HashikaChathubhashaka/Hot-plate-cotroller-using-PID/README.md

# Hot-plate-cotroller-using-PID

<h3>This is  a analog electronic project about making a hot plate temperature controller using PID algorithm.  </h3>

<h4> There are 4 main circuit units use to this. </h4>

<ol>
 <li>PID unit  </li>
  
 <li>Sensor Interface Unit </li>
  
 <li>Firing angle control unit  </li>
  
 <li>Power Supply Unit  </li>
  
 </ol>

<h4>Softwares And Platforms</h4>
<ul>

<li>Simulate circuit --> <i>Multisim</i> </li>
<li>PCBs --> <i>Altium  </i> </li>
<li>encloser --> <i> SolidWorks </i>  </li>
<li>Digital Display --> <i> Arduino  </i> </li>


</ul>
