HashikaChathubhashaka/Hot-plate-cotroller-using-PID/Multisim Simulations/firing angle.jpg

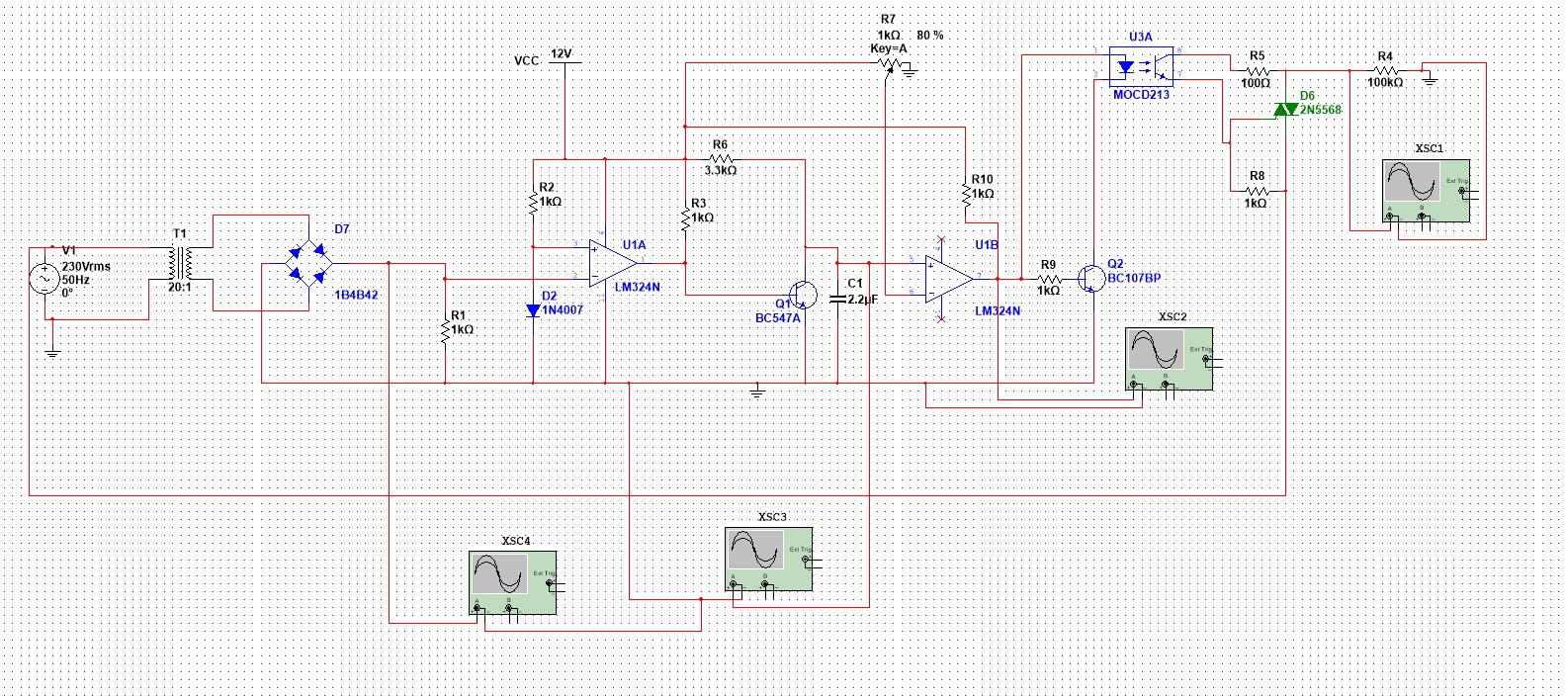
Multisim Simulations/firing angle.jpg
