HashikaChathubhashaka/Hot-plate-cotroller-using-PID/Multisim Simulations/PID.jpg

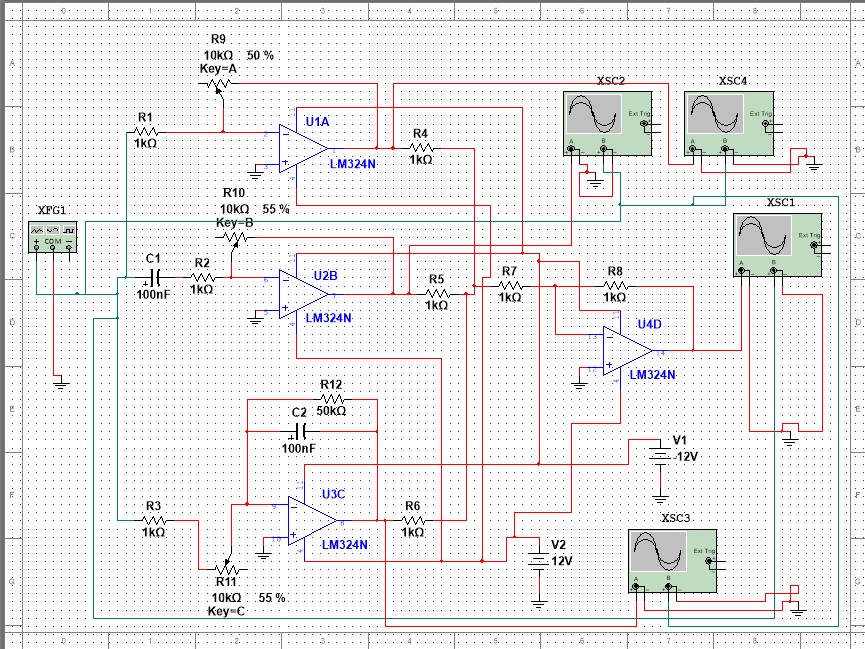
Multisim Simulations/PID.jpg
