HashikaChathubhashaka/Hot-plate-cotroller-using-PID/Multisim Simulations/power supply.jpg

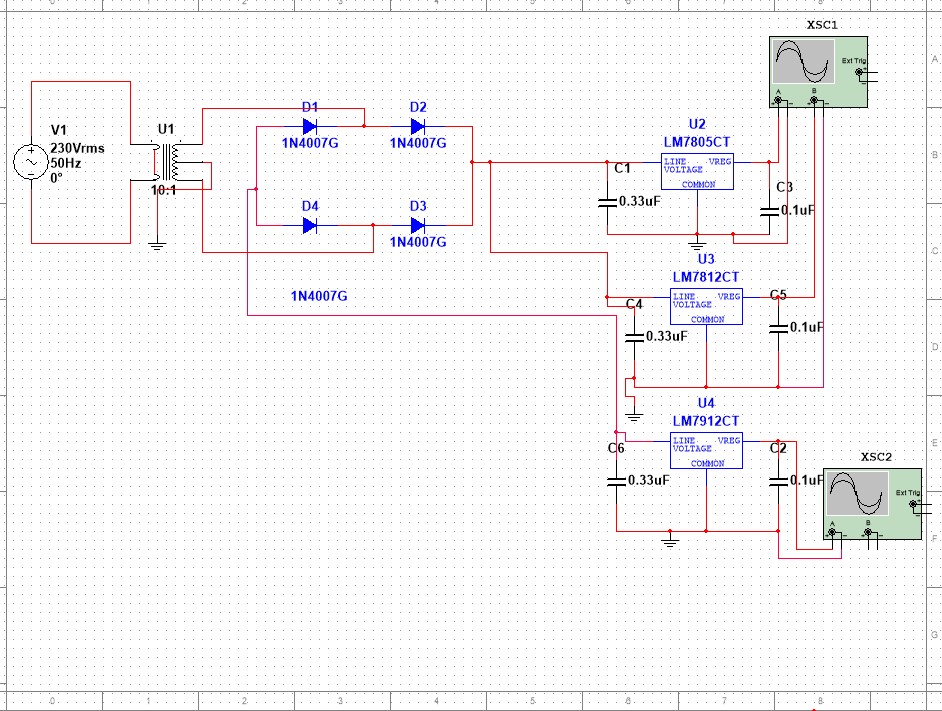
Multisim Simulations/power supply.jpg
