HashikaChathubhashaka/Hot-plate-cotroller-using-PID/Multisim Simulations/sensor interface.jpg

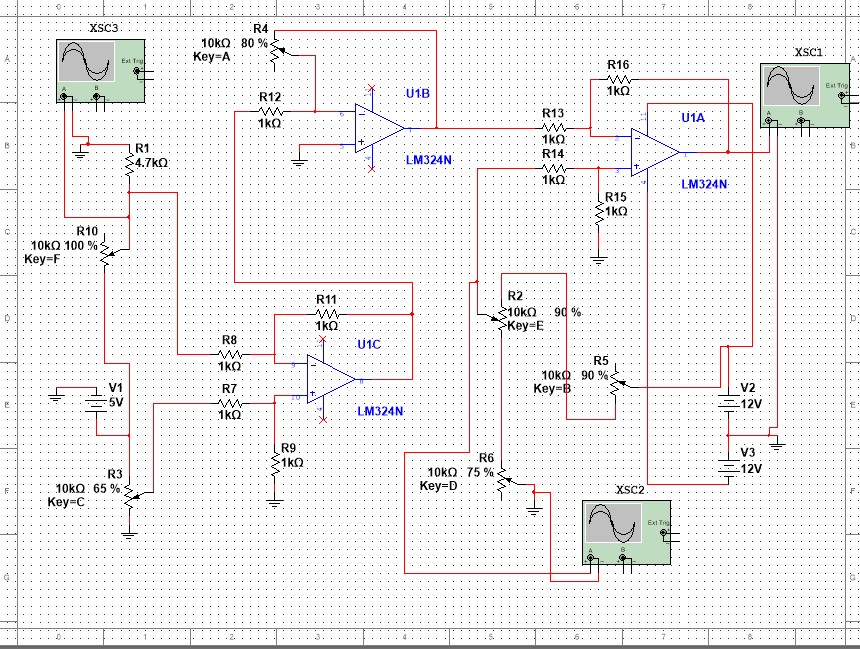
Multisim Simulations/sensor interface.jpg
