HashikaChathubhashaka/Hot-plate-cotroller-using-PID/Schemitics/Firing Angle.pdf

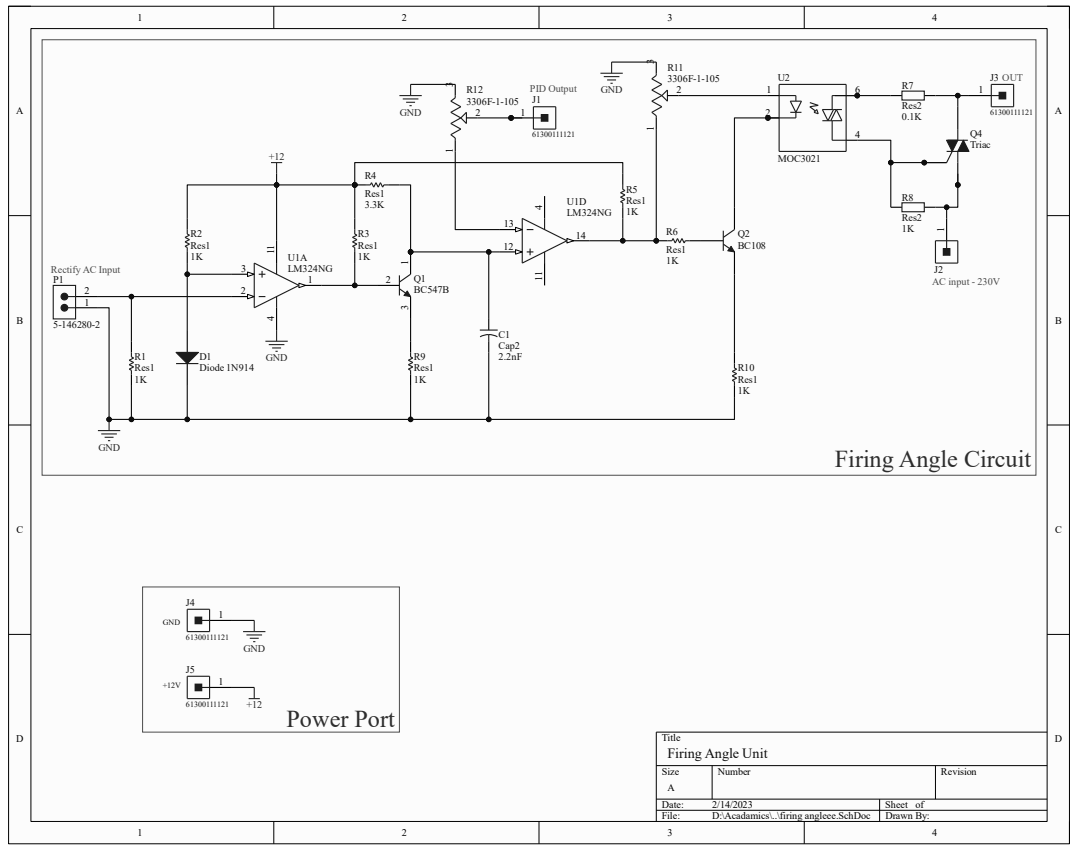
[picture p35: page 1]
