HashikaChathubhashaka/Hot-plate-cotroller-using-PID/Schemitics/Power Supply.pdf

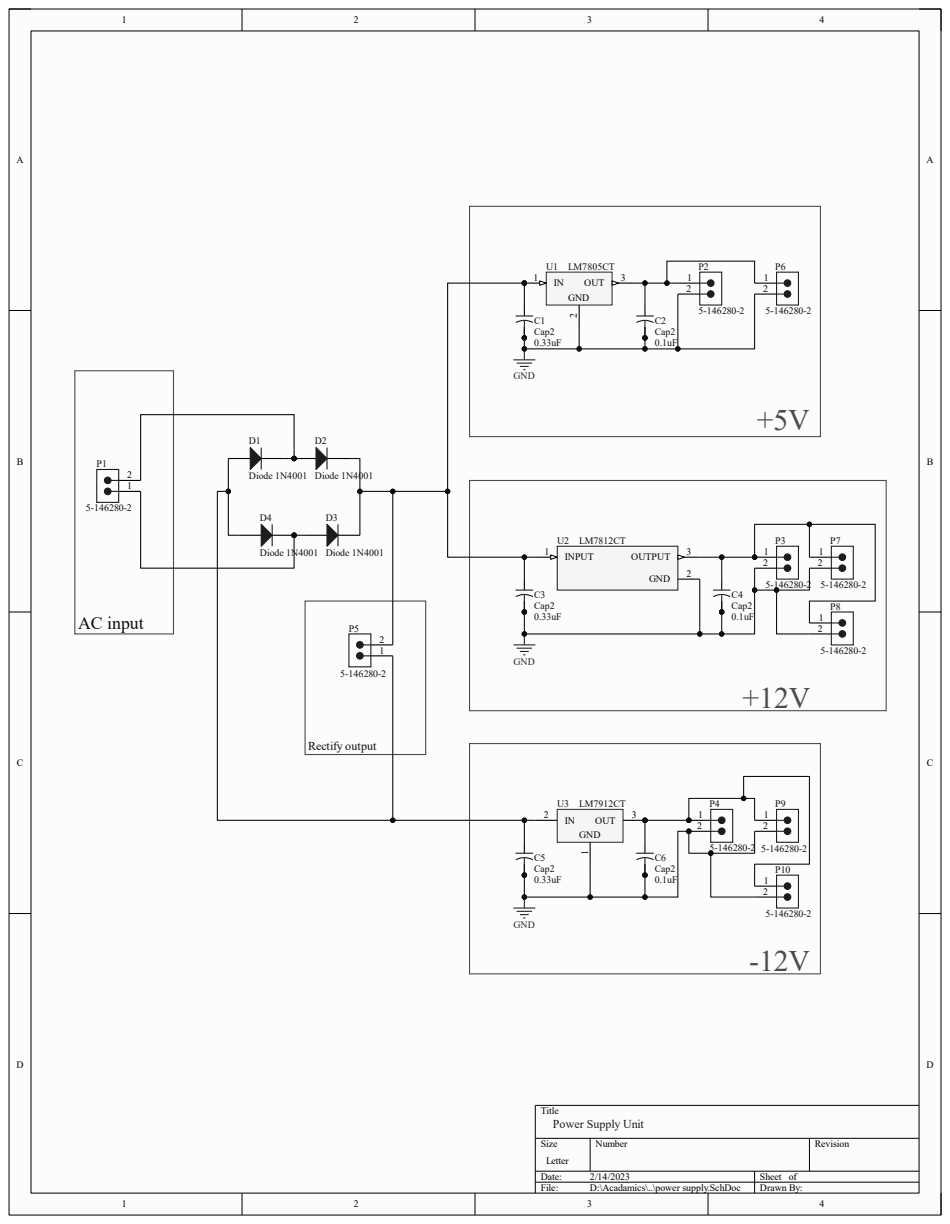
[picture p36: page 1]
