HashikaChathubhashaka/Hot-plate-cotroller-using-PID/Schemitics/Sensor Interface.pdf

# Res1 1 3

# Res1 1 3

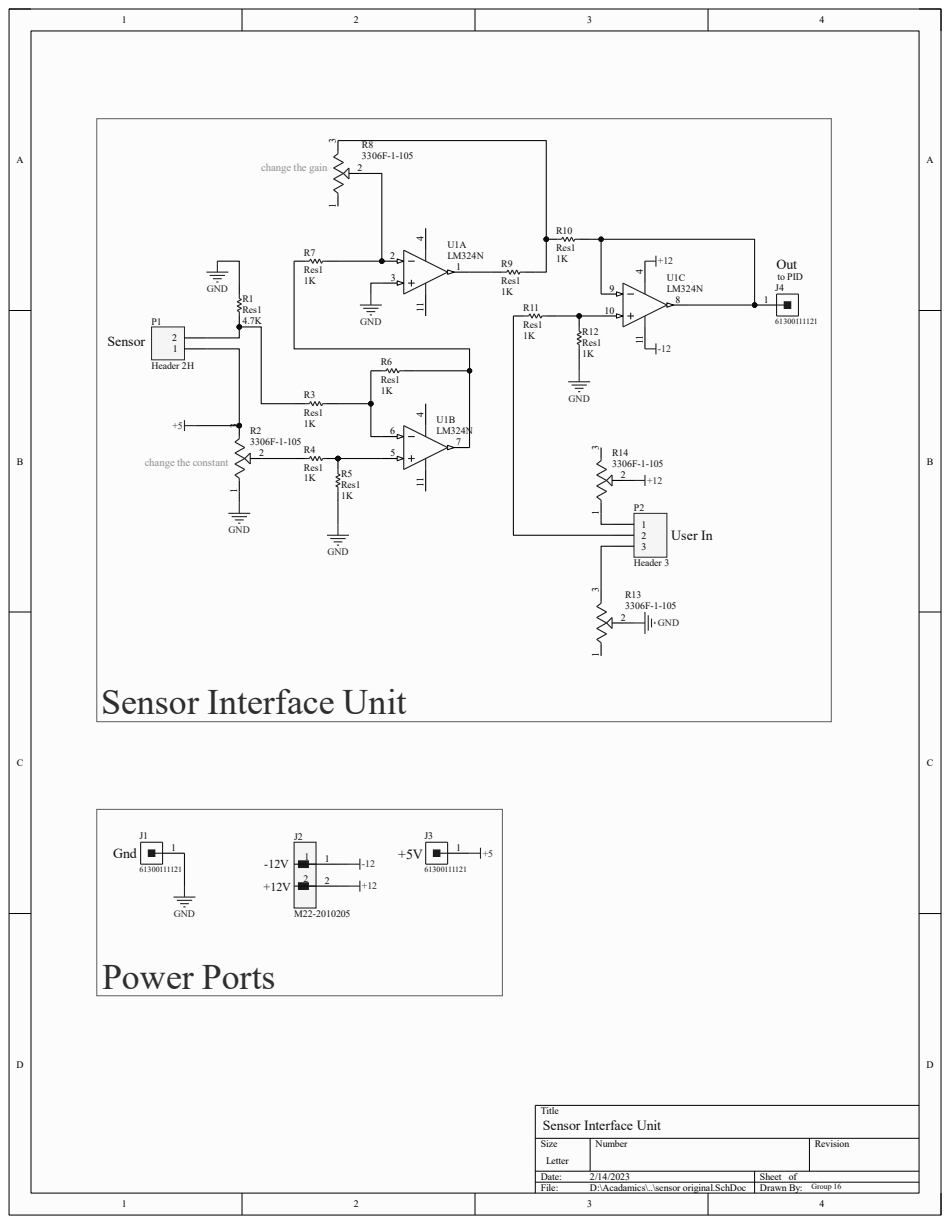
[picture p37: page 1]
