HashikaChathubhashaka/Hot-plate-cotroller-using-PID/Schemitics/PID.pdf

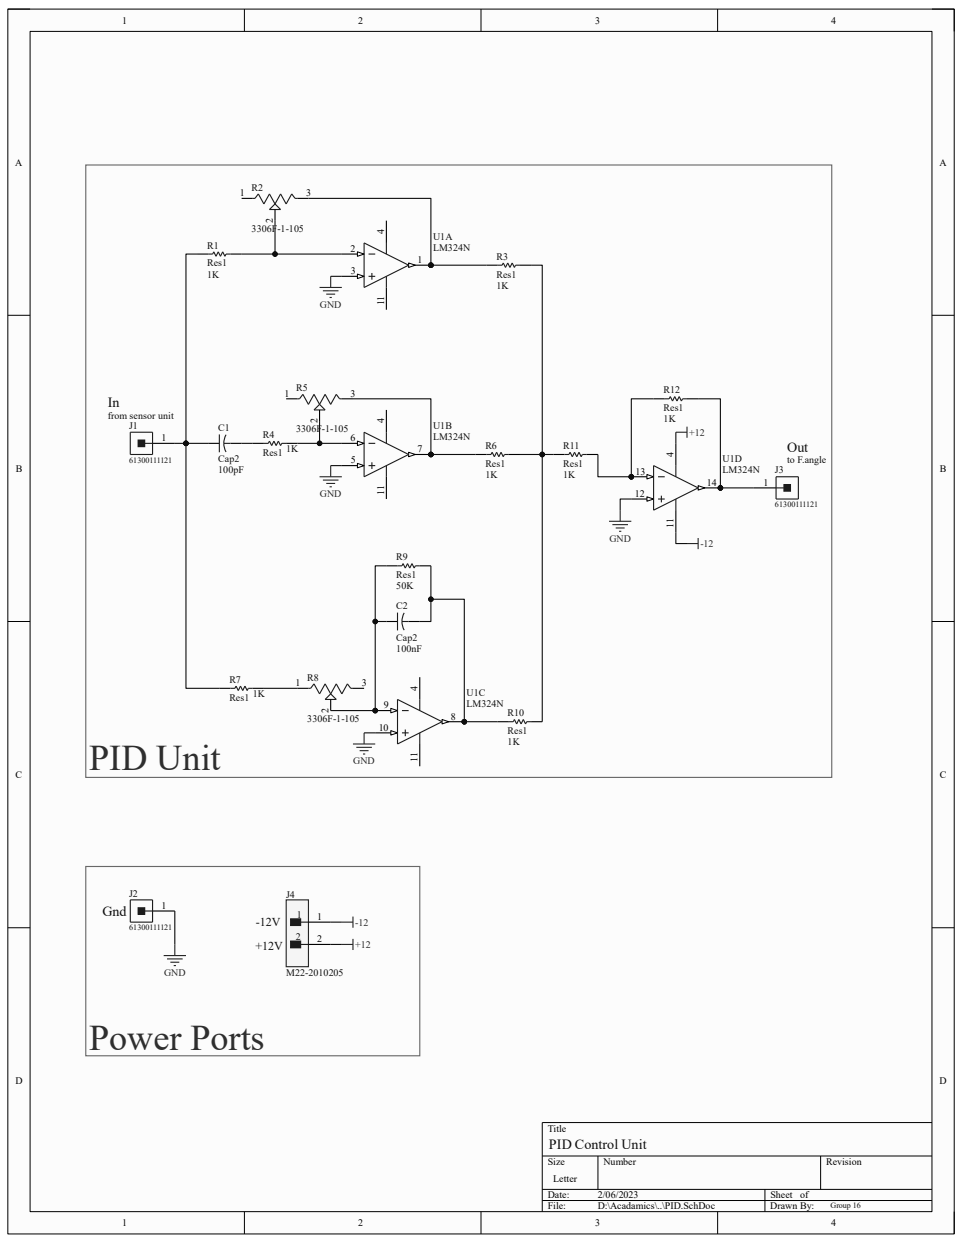
[picture p38: page 1]
