HashikaChathubhashaka/Hot-plate-cotroller-using-PID/(list of files, drawings)

Other design files:
Multisim Simulations/Firing angle control unit.ms14
Multisim Simulations/PID unit.ms14
Multisim Simulations/PowerSupply unit.ms14
Multisim Simulations/Sensor interface unit.ms14
